G-Pereira/greenmobi-drive/hardware/docs/Untitled 1.ods

R | 4,7
C | 0,000001
t | 0,0000047
3t | 0,0000141
fsw | 3,00E+04
half period | 1,66666666666667E-05
leftover time to charge | 84,6
