G-Pereira/greenmobi-drive/hardware/greenmobi-drive.kicad_pcb

## KiCad design hardware/greenmobi-drive.kicad_pcb (2025-09-25)

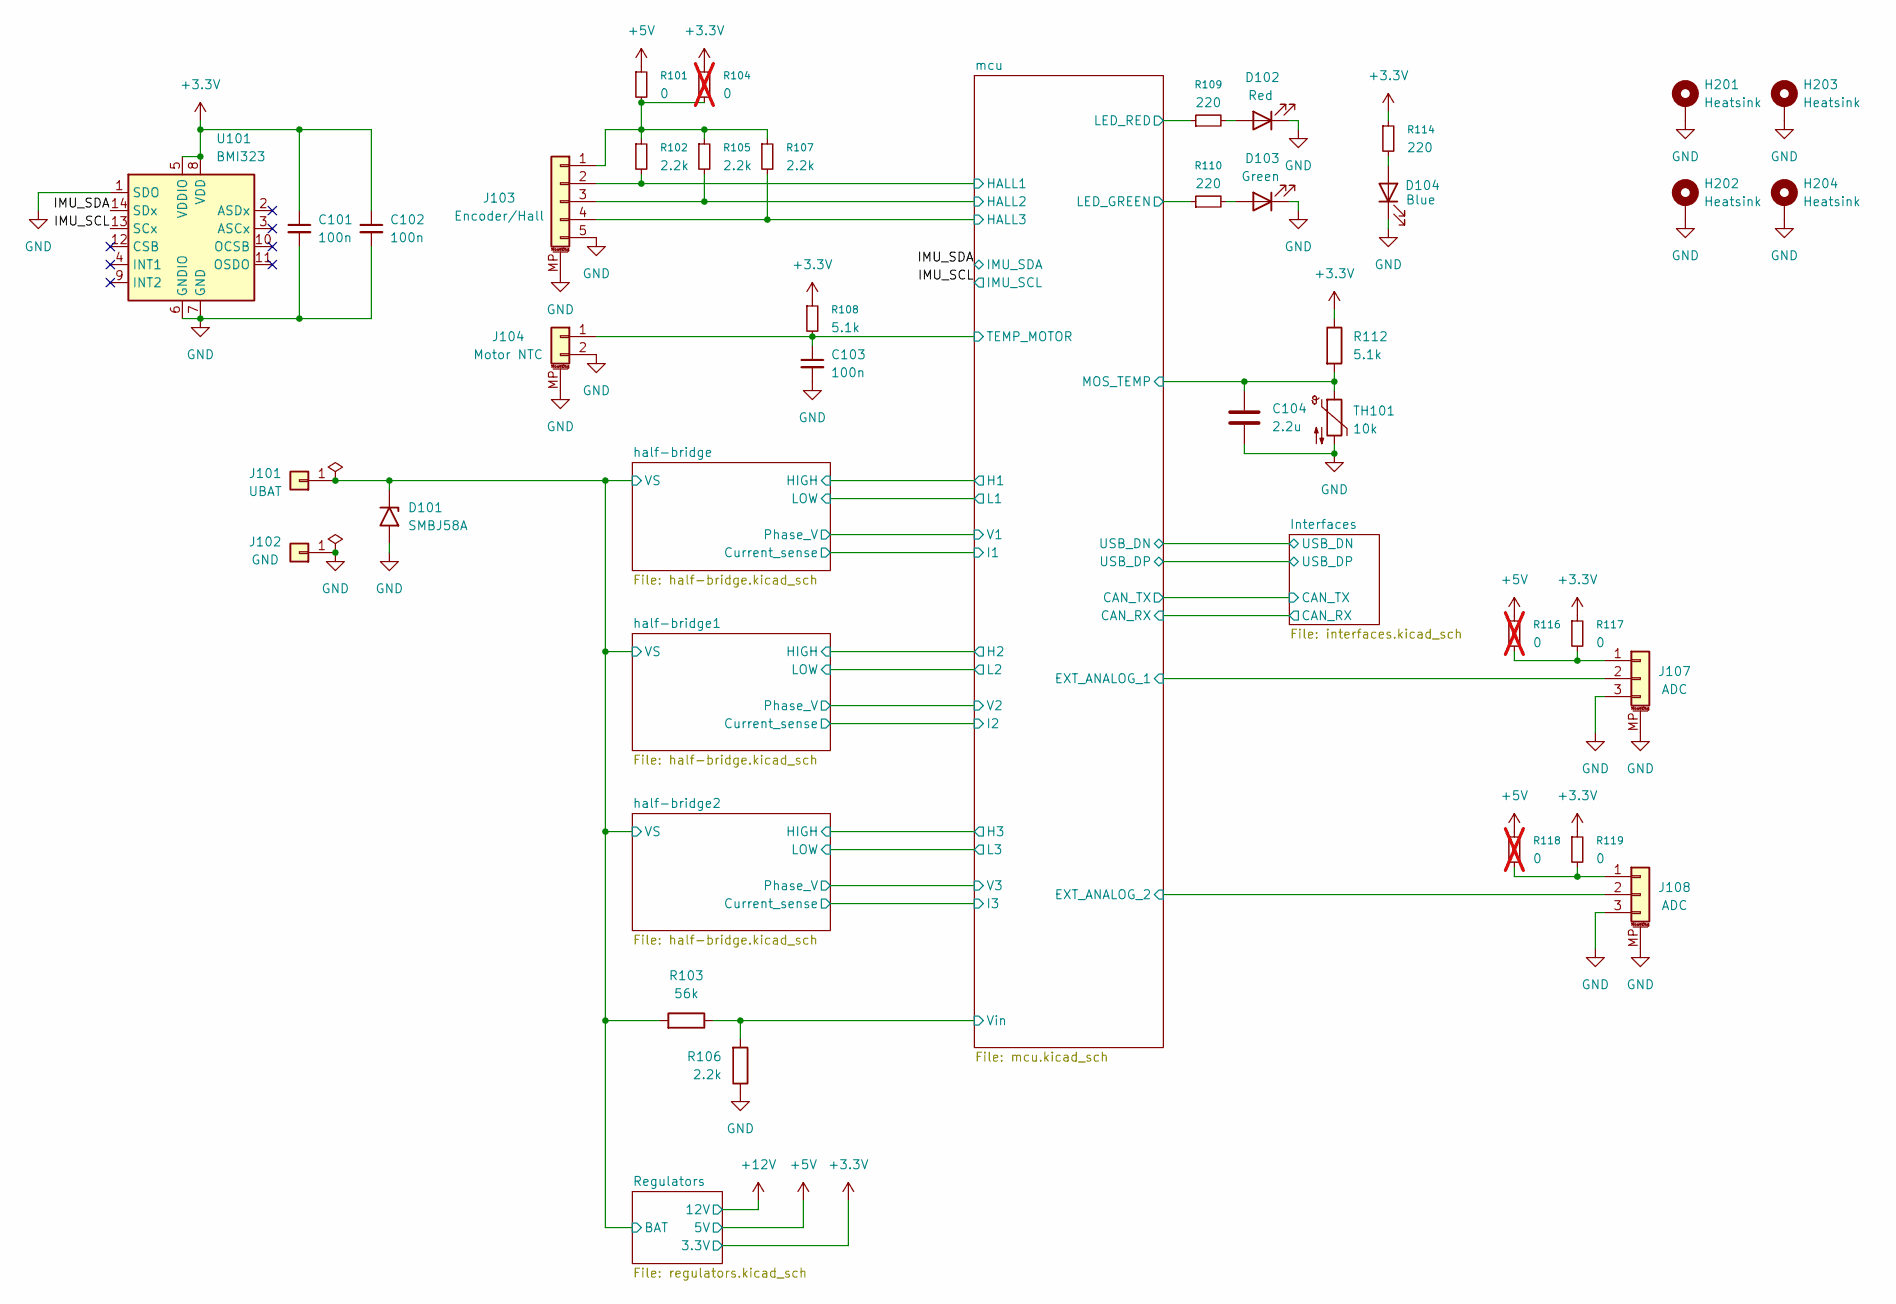
[picture p1: schematic greenmobi-drive.kicad_sch, GreenMobi Drive]

Parts:
C101, C102, C103: 100n; C_0402_1005Metric; LCSC C77020
C104: 2.2u; C_0402_1005Metric; LCSC C170151
D101: SMBJ58A; D_SMB; LCSC C151910
D102: Red; LED_0805_2012Metric; LCSC C688884
D103: Green; LED_0805_2012Metric; LCSC C688883
D104: Blue; LED_0805_2012Metric; LCSC C779459
H201, H202, H203, H204: Heatsink; MountingHole_3.2mm_M3_Pad
J101: UBAT; MountingHole_3.2mm_M3_ISO14580_Pad_TopBottom
J102: GND; MountingHole_3.2mm_M3_ISO14580_Pad_TopBottom
J103: Encoder/Hall; JST_PH_B5B-PH-SM4-TB_1x05-1MP_P2.00mm_Vertical; LCSC C17700383
J104: Motor NTC; JST_PH_B2B-PH-SM4-TB_1x02-1MP_P2.00mm_Vertical; LCSC C17700380
J107, J108: ADC; JST_PH_B3B-PH-SM4-TB_1x03-1MP_P2.00mm_Vertical; LCSC C17700383
R101, R117, R119: 0; R_0402_1005Metric; LCSC C106231
R102, R105, R106, R107: 2.2k; R_0402_1005Metric; LCSC C114762
R103: 56k; R_0805_2012Metric; LCSC C17756
R104, R116, R118: 0; R_0402_1005Metric; LCSC C106231; not fitted
R108, R112: 5.1k; R_0402_1005Metric; LCSC C25905
R109, R110, R114: 220; R_0402_1005Metric; LCSC C2909336
TH101: 10k; R_0402_1005Metric; LCSC C77131
U101: BMI323; Bosch_LGA-14_3x2.5mm_P0.5mm; LCSC C5368700

Connections:
+3.3V: C101.1, C102.1, R104.1, R108.1, R112.1, R114.1, R117.1, R119.1, U101.5 (VDDIO), U101.8 (VDD); also elsewhere on the board
+5V: R101.1, R116.1, R118.1; also elsewhere on the board
/IMU_SCL: U101.13 (SCx); also elsewhere on the board
/IMU_SDA: U101.14 (SDx); also elsewhere on the board
/Regulators/BAT: D101.1 (A1), J101.1, R103.2; also elsewhere on the board
/mcu/EXT_ANALOG_1: J107.2; also elsewhere on the board
/mcu/EXT_ANALOG_2: J108.2; also elsewhere on the board
/mcu/HALL1: J103.2, R102.2; also elsewhere on the board
/mcu/HALL2: J103.3, R105.2; also elsewhere on the board
/mcu/HALL3: J103.4, R107.2; also elsewhere on the board
/mcu/LED_GREEN: R110.1; also elsewhere on the board
/mcu/LED_RED: R109.1; also elsewhere on the board
/mcu/MOS_TEMP: C104.1, R112.2, TH101.1; also elsewhere on the board
/mcu/TEMP_MOTOR: C103.1, J104.1, R108.2; also elsewhere on the board
/mcu/Vin: R103.1, R106.2; also elsewhere on the board
GND: C101.2, C102.2, C103.2, C104.2, D101.2 (A2), D102.1 (K), D103.1 (K), D104.1 (K), H201.1, H202.1, H203.1, H204.1, J102.1, J103.5, J103.MP (MountPin), J104.2, J104.MP (MountPin), J107.3, J107.MP (MountPin), J108.3, J108.MP (MountPin), R106.1, TH101.2, U101.1 (SDO), U101.6 (GNDIO), U101.7 (GND); also elsewhere on the board
unnamed: D102.2 (A), R109.2
unnamed: D103.2 (A), R110.2
unnamed: D104.2 (A), R114.2
unnamed: J103.1, R101.2, R102.1, R104.2, R105.1, R107.1
unnamed: J107.1, R116.2, R117.2
unnamed: J108.1, R118.2, R119.2

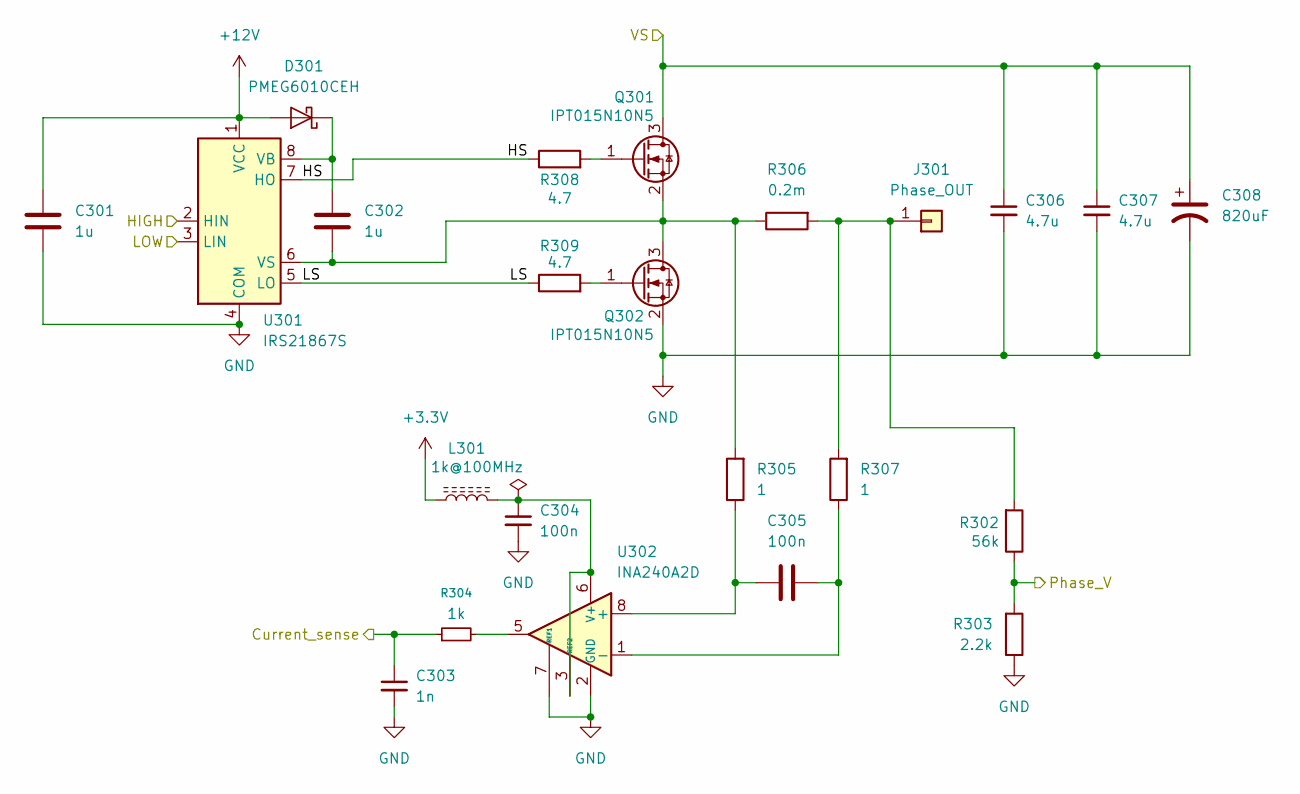
[picture p2: schematic half-bridge.kicad_sch, GreenMobi Drive]

Parts:
C301, C302: 1u; C_1206_3216Metric; LCSC C28322
C303: 1n; C_0402_1005Metric
C304, C305: 100n; C_0402_1005Metric; LCSC C77020
C306, C307: 4.7u; C_1210_3225Metric; LCSC C381466
C308: 820uF; CP_Radial_D18.0mm_P7.50mm; LCSC C700880
D301: PMEG6010CEH; D_SOD-123F; LCSC C110797
J301: Phase_OUT; SolderWirePad_1x01_SMD_4x8mm
L301: 1k@100MHz; L_0402_1005Metric; LCSC C76883
Q301, Q302: IPT015N10N5; Infineon_PG-HSOF-8-1_ThermalVias; LCSC C108964
R302: 56k; R_0805_2012Metric; LCSC C17756
R303: 2.2k; R_0402_1005Metric; LCSC C114762
R304: 1k; R_0402_1005Metric
R305, R307: 1; R_0402_1005Metric; LCSC C185446
R306: 0.2m; R_2512_6332Metric; LCSC C4944115
R308, R309: 4.7; R_0603_1608Metric; LCSC C25121
U301: IRS21867S; SOIC-8_3.9x4.9mm_P1.27mm; LCSC C52290
U302: INA240A2D; SOIC-8_3.9x4.9mm_P1.27mm; LCSC C2060768

Connections:
+3.3V: L301.1; also elsewhere on the board
+12V: C301.1, D301.2 (A), U301.1 (VCC); also elsewhere on the board
/Regulators/BAT: C306.1, C307.1, C308.1, Q301.3 (D); also elsewhere on the board
/half-bridge/Current_sense: C303.1, R304.1; also elsewhere on the board
/half-bridge/HIGH: U301.2 (HIN); also elsewhere on the board
/half-bridge/HS: R308.1, U301.7 (HO)
/half-bridge/LOW: U301.3 (LIN); also elsewhere on the board
/half-bridge/LS: R309.1, U301.5 (LO)
/half-bridge/Phase_V: R302.1, R303.2; also elsewhere on the board
GND: C301.2, C303.2, C304.2, C306.2, C307.2, C308.2, Q302.2 (S), R303.1, U301.4 (COM), U302.2 (GND), U302.4 (GND), U302.7 (REF1); also elsewhere on the board
unnamed: C302.1, D301.1 (K), U301.8 (VB)
unnamed: J301.1, R302.2, R306.2, R307.2
unnamed: Q301.1 (G), R308.2
unnamed: C302.2, Q301.2 (S), Q302.3 (D), R305.2, R306.1, U301.6 (VS)
unnamed: Q302.1 (G), R309.2
unnamed: R304.2, U302.5
unnamed: C305.2, R305.1, U302.8 (+)
unnamed: C305.1, R307.1, U302.1 (-)
unnamed: C304.1, L301.2, U302.3 (REF2), U302.6 (V+)

Parts of its further copies:
C401, C402, C501, C502: 1u; C_1206_3216Metric; LCSC C28322
C403, C503: 1n; C_0402_1005Metric
C404, C405, C504, C505: 100n; C_0402_1005Metric; LCSC C77020
C406, C407, C506, C507: 4.7u; C_1210_3225Metric; LCSC C381466
C408, C508: 820uF; CP_Radial_D18.0mm_P7.50mm; LCSC C700880
D401, D501: PMEG6010CEH; D_SOD-123F; LCSC C110797
J401, J501: Phase_OUT; SolderWirePad_1x01_SMD_4x8mm
L401, L501: 1k@100MHz; L_0402_1005Metric; LCSC C76883
Q401, Q402, Q501, Q502: IPT015N10N5; Infineon_PG-HSOF-8-1_ThermalVias; LCSC C108964
R402, R502: 56k; R_0805_2012Metric; LCSC C17756
R403, R503: 2.2k; R_0402_1005Metric; LCSC C114762
R404, R504: 1k; R_0402_1005Metric
R405, R407, R505, R507: 1; R_0402_1005Metric; LCSC C185446
R406, R506: 0.2m; R_2512_6332Metric; LCSC C4944115
R408, R409, R508, R509: 4.7; R_0603_1608Metric; LCSC C25121
U401, U501: IRS21867S; SOIC-8_3.9x4.9mm_P1.27mm; LCSC C52290
U402, U502: INA240A2D; SOIC-8_3.9x4.9mm_P1.27mm; LCSC C2060768

Connections of its further copies:
+3.3V: L401.1, L501.1; also elsewhere on the board
+12V: C401.1, C501.1, D401.2 (A), D501.2 (A), U401.1 (VCC), U501.1 (VCC); also elsewhere on the board
/Regulators/BAT: C406.1, C407.1, C408.1, C506.1, C507.1, C508.1, Q401.3 (D), Q501.3 (D); also elsewhere on the board
/half-bridge1/Current_sense: C403.1, R404.1; also elsewhere on the board
/half-bridge1/HIGH: U401.2 (HIN); also elsewhere on the board
/half-bridge1/HS: R408.1, U401.7 (HO)
/half-bridge1/LOW: U401.3 (LIN); also elsewhere on the board
/half-bridge1/LS: R409.1, U401.5 (LO)
/half-bridge1/Phase_V: R402.1, R403.2; also elsewhere on the board
/half-bridge2/Current_sense: C503.1, R504.1; also elsewhere on the board
/half-bridge2/HIGH: U501.2 (HIN); also elsewhere on the board
/half-bridge2/HS: R508.1, U501.7 (HO)
/half-bridge2/LOW: U501.3 (LIN); also elsewhere on the board
/half-bridge2/LS: R509.1, U501.5 (LO)
/half-bridge2/Phase_V: R502.1, R503.2; also elsewhere on the board
GND: C401.2, C403.2, C404.2, C406.2, C407.2, C408.2, C501.2, C503.2, C504.2, C506.2, C507.2, C508.2, Q402.2 (S), Q502.2 (S), R403.1, R503.1, U401.4 (COM), U402.2 (GND), U402.4 (GND), U402.7 (REF1), U501.4 (COM), U502.2 (GND), U502.4 (GND), U502.7 (REF1); also elsewhere on the board
unnamed: C402.1, D401.1 (K), U401.8 (VB)
unnamed: C502.1, D501.1 (K), U501.8 (VB)
unnamed: J401.1, R402.2, R406.2, R407.2
unnamed: J501.1, R502.2, R506.2, R507.2
unnamed: Q401.1 (G), R408.2
unnamed: C402.2, Q401.2 (S), Q402.3 (D), R405.2, R406.1, U401.6 (VS)
unnamed: Q402.1 (G), R409.2
unnamed: Q501.1 (G), R508.2
unnamed: C502.2, Q501.2 (S), Q502.3 (D), R505.2, R506.1, U501.6 (VS)
unnamed: Q502.1 (G), R509.2
unnamed: R404.2, U402.5
unnamed: R504.2, U502.5
unnamed: C405.2, R405.1, U402.8 (+)
unnamed: C405.1, R407.1, U402.1 (-)
unnamed: C404.1, L401.2, U402.3 (REF2), U402.6 (V+)
unnamed: C505.2, R505.1, U502.8 (+)
unnamed: C505.1, R507.1, U502.1 (-)
unnamed: C504.1, L501.2, U502.3 (REF2), U502.6 (V+)

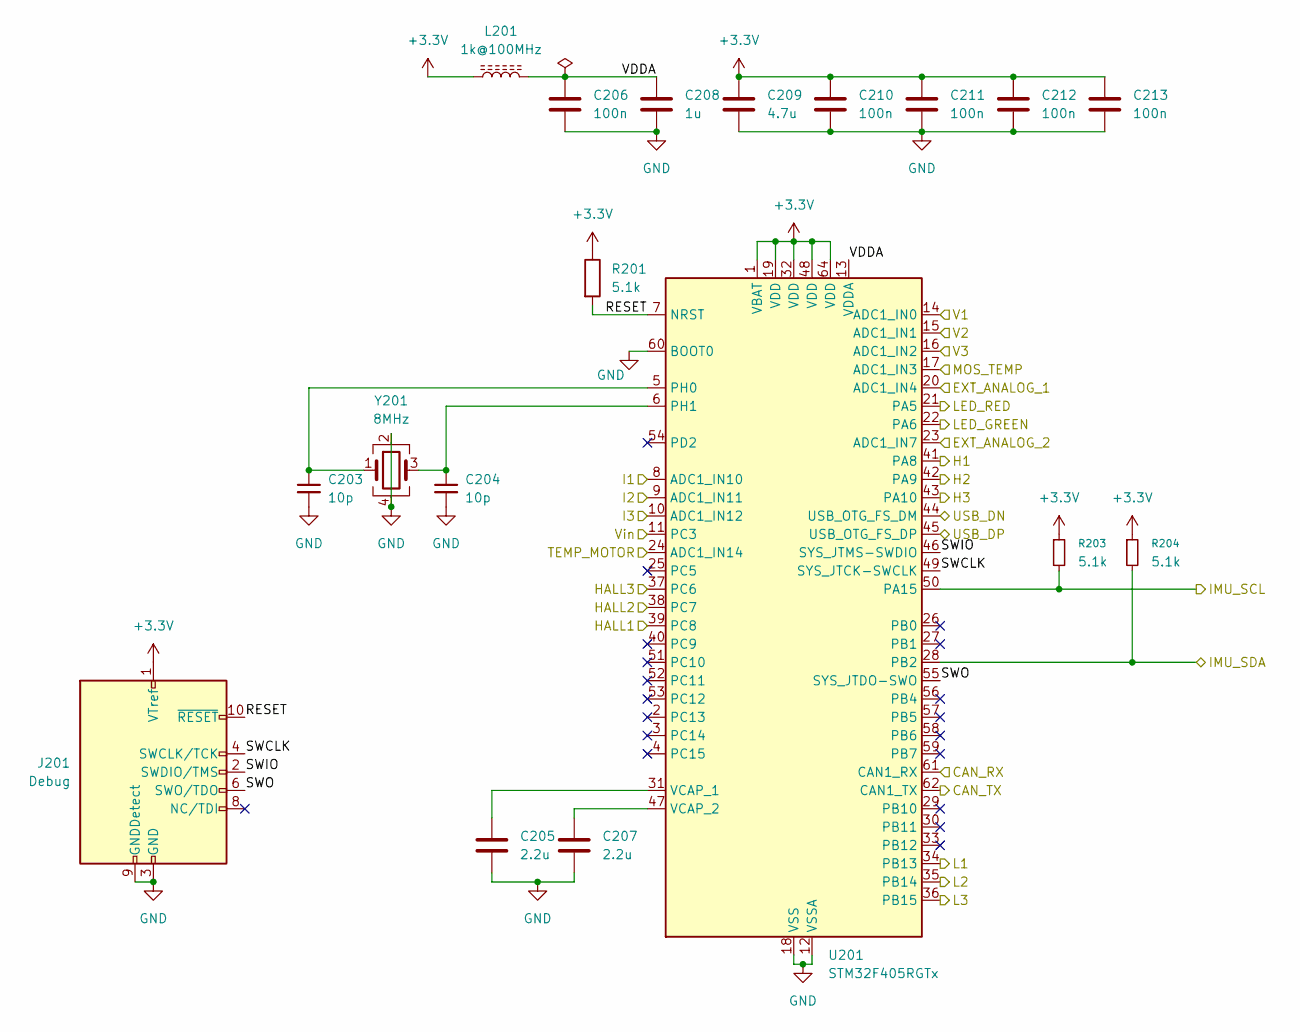
[picture p3: schematic mcu.kicad_sch, GreenMobi Drive]

Parts:
C203, C204: 10p; C_0402_1005Metric; LCSC C526994
C205, C207: 2.2u; C_0402_1005Metric; LCSC C170151
C206, C210, C211, C212, C213: 100n; C_0402_1005Metric; LCSC C77020
C208: 1u; C_0402_1005Metric; LCSC C14445
C209: 4.7u; C_0402_1005Metric; LCSC C23733
J201: Debug; PinHeader_2x05_P1.27mm_Vertical_SMD; LCSC C150517
L201: 1k@100MHz; L_0402_1005Metric; LCSC C76883
R201, R203, R204: 5.1k; R_0402_1005Metric; LCSC C25905
U201: STM32F405RGTx; LQFP-64_10x10mm_P0.5mm; LCSC C15742
Y201: 8MHz; Crystal_SMD_3225-4Pin_3.2x2.5mm; LCSC C400090

Connections:
+3.3V: C209.1, C210.1, C211.1, C212.1, C213.1, J201.1 (VTref), L201.1, R201.1, R203.1, R204.1, U201.1 (VBAT), U201.19 (VDD), U201.32 (VDD), U201.48 (VDD), U201.64 (VDD); also elsewhere on the board
/IMU_SCL: R203.2, U201.50 (PA15); also elsewhere on the board
/IMU_SDA: R204.2, U201.28 (PB2); also elsewhere on the board
/Interfaces/CAN_RX: U201.61 (CAN1_RX); also elsewhere on the board
/Interfaces/CAN_TX: U201.62 (CAN1_TX); also elsewhere on the board
/Interfaces/USB_DN: U201.44 (USB_OTG_FS_DM); also elsewhere on the board
/Interfaces/USB_DP: U201.45 (USB_OTG_FS_DP); also elsewhere on the board
/half-bridge1/Current_sense: U201.9 (ADC1_IN11); also elsewhere on the board
/half-bridge1/HIGH: U201.42 (PA9); also elsewhere on the board
/half-bridge1/LOW: U201.35 (PB14); also elsewhere on the board
/half-bridge1/Phase_V: U201.15 (ADC1_IN1); also elsewhere on the board
/half-bridge2/Current_sense: U201.10 (ADC1_IN12); also elsewhere on the board
/half-bridge2/HIGH: U201.43 (PA10); also elsewhere on the board
/half-bridge2/LOW: U201.36 (PB15); also elsewhere on the board
/half-bridge2/Phase_V: U201.16 (ADC1_IN2); also elsewhere on the board
/half-bridge/Current_sense: U201.8 (ADC1_IN10); also elsewhere on the board
/half-bridge/HIGH: U201.41 (PA8); also elsewhere on the board
/half-bridge/LOW: U201.34 (PB13); also elsewhere on the board
/half-bridge/Phase_V: U201.14 (ADC1_IN0); also elsewhere on the board
/mcu/EXT_ANALOG_1: U201.20 (ADC1_IN4); also elsewhere on the board
/mcu/EXT_ANALOG_2: U201.23 (ADC1_IN7); also elsewhere on the board
/mcu/HALL1: U201.39 (PC8); also elsewhere on the board
/mcu/HALL2: U201.38 (PC7); also elsewhere on the board
/mcu/HALL3: U201.37 (PC6); also elsewhere on the board
/mcu/LED_GREEN: U201.22 (PA6); also elsewhere on the board
/mcu/LED_RED: U201.21 (PA5); also elsewhere on the board
/mcu/MOS_TEMP: U201.17 (ADC1_IN3); also elsewhere on the board
/mcu/RESET: J201.10 (~RESET), R201.2, U201.7 (NRST)
/mcu/SWCLK: J201.4 (SWCLK/TCK), U201.49 (SYS_JTCK-SWCLK)
/mcu/SWIO: J201.2 (SWDIO/TMS), U201.46 (SYS_JTMS-SWDIO)
/mcu/SWO: J201.6 (SWO/TDO), U201.55 (SYS_JTDO-SWO)
/mcu/TEMP_MOTOR: U201.24 (ADC1_IN14); also elsewhere on the board
/mcu/VDDA: C206.1, C208.1, L201.2, U201.13 (VDDA)
/mcu/Vin: U201.11 (PC3); also elsewhere on the board
GND: C203.2, C204.2, C205.2, C206.2, C207.2, C208.2, C209.2, C210.2, C211.2, C212.2, C213.2, J201.3 (GND), J201.5 (GND), J201.9 (GNDDetect), U201.12 (VSSA), U201.18 (VSS), U201.60 (BOOT0), U201.63 (VSS), Y201.2, Y201.4; also elsewhere on the board
unnamed: C203.1, U201.5 (PH0), Y201.1
unnamed: C204.1, U201.6 (PH1), Y201.3
unnamed: C205.1, U201.31 (VCAP_1)
unnamed: C207.1, U201.47 (VCAP_2)

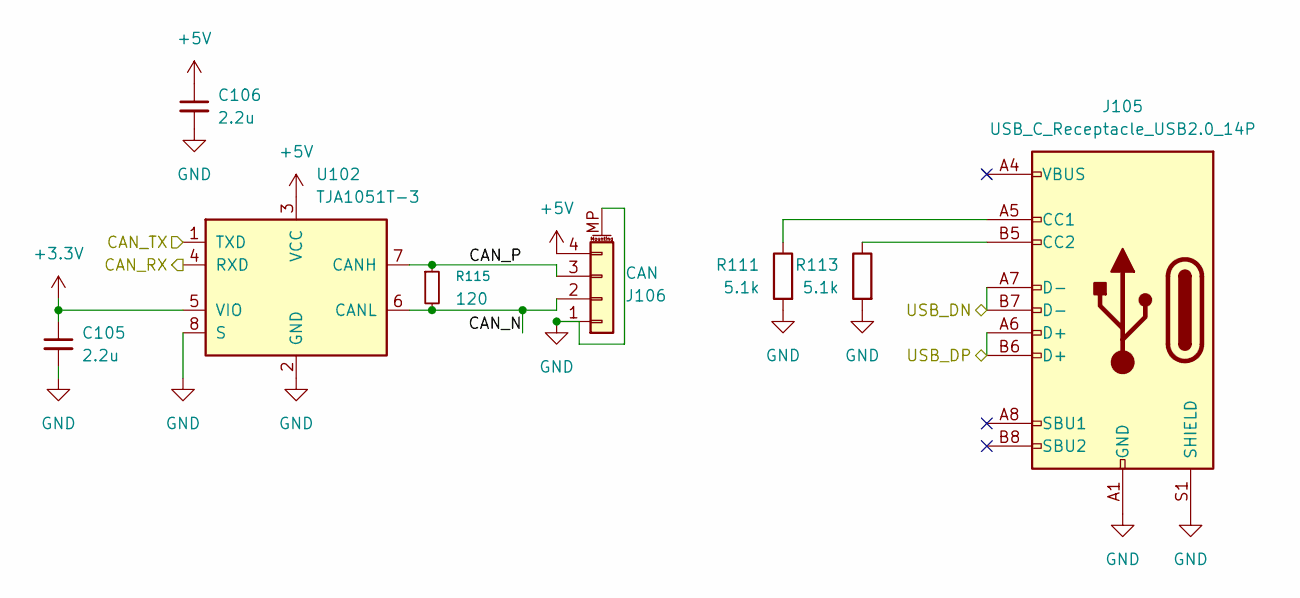
[picture p4: schematic interfaces.kicad_sch, GreenMobi Drive]

Parts:
C105, C106: 2.2u; C_0402_1005Metric; LCSC C170151
J105: USB_C_Receptacle_USB2.0_14P; USB_C_Receptacle_Palconn_UTC16-G; LCSC C2765186
J106: CAN; JST_PH_B4B-PH-SM4-TB_1x04-1MP_P2.00mm_Vertical; LCSC C17700382
R111, R113: 5.1k; R_0402_1005Metric; LCSC C25905
R115: 120; R_0402_1005Metric; LCSC C25079
U102: TJA1051T-3; SOIC-8_3.9x4.9mm_P1.27mm; LCSC C38695

Connections:
+3.3V: C105.1, U102.5 (VIO); also elsewhere on the board
+5V: C106.1, J106.4, U102.3 (VCC); also elsewhere on the board
/Interfaces/CAN_N: J106.2, R115.2, U102.6 (CANL)
/Interfaces/CAN_P: J106.3, R115.1, U102.7 (CANH)
/Interfaces/CAN_RX: U102.4 (RXD); also elsewhere on the board
/Interfaces/CAN_TX: U102.1 (TXD); also elsewhere on the board
/Interfaces/USB_DN: J105.A7 (D-), J105.B7 (D-); also elsewhere on the board
/Interfaces/USB_DP: J105.A6 (D+), J105.B6 (D+); also elsewhere on the board
GND: C105.2, C106.2, J105.A1 (GND), J105.A12 (GND), J105.B1 (GND), J105.B12 (GND), J105.S1 (SHIELD), J106.1, J106.MP (MountPin), R111.2, R113.2, U102.2 (GND), U102.8 (S); also elsewhere on the board
unnamed: J105.A5 (CC1), R111.1
unnamed: J105.B5 (CC2), R113.1

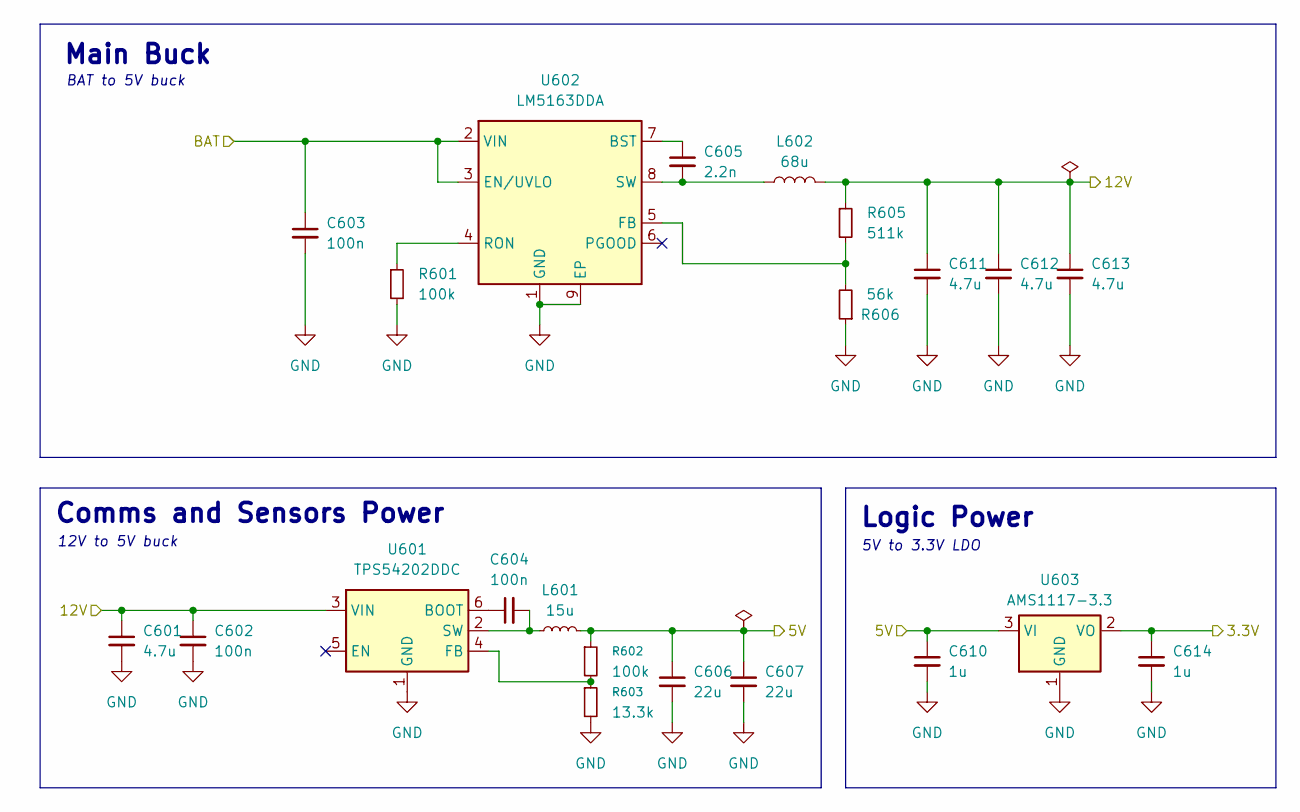
[picture p5: schematic regulators.kicad_sch, GreenMobi Drive]

Parts:
C601, C611, C612, C613: 4.7u; C_0805_2012Metric; LCSC C1779
C602, C604: 100n; C_0402_1005Metric; LCSC C77020
C603: 100n; C_1206_3216Metric; LCSC C110255
C605: 2.2n; C_0402_1005Metric; LCSC C106861
C606, C607: 22u; C_0805_2012Metric; LCSC C45783
C610, C614: 1u; C_1206_3216Metric; LCSC C28322
L601: 15u; L_Chilisin_BMRA00040420; LCSC C2894719
L602: 68u; L_KOHERelec_MDA7030; LCSC C2894721
R601, R602: 100k; R_0402_1005Metric; LCSC C60491
R603: 13.3k; R_0402_1005Metric; LCSC C2974007
R605: 511k; R_0603_1608Metric; LCSC C2930114
R606: 56k; R_0805_2012Metric; LCSC C17756
U601: TPS54202DDC; SOT-23-6; LCSC C191884
U602: LM5163DDA; HSOP-8-1EP_3.9x4.9mm_P1.27mm_EP2.41x3.1mm_ThermalVias; LCSC C2873264
U603: AMS1117-3.3; SOT-223-3_TabPin2; LCSC C6186

Connections:
+3.3V: C614.1, U603.2 (VO); also elsewhere on the board
+5V: C606.1, C607.1, C610.1, L601.2, R602.1, U603.3 (VI); also elsewhere on the board
+12V: C601.1, C602.1, C611.1, C612.1, C613.1, L602.2, R605.1, U601.3 (VIN); also elsewhere on the board
/Regulators/BAT: C603.1, U602.2 (VIN), U602.3 (EN/UVLO); also elsewhere on the board
GND: C601.2, C602.2, C603.2, C606.2, C607.2, C610.2, C611.2, C612.2, C613.2, C614.2, R601.2, R603.2, R606.1, U601.1 (GND), U602.1 (GND), U602.9 (EP), U603.1 (GND); also elsewhere on the board
unnamed: C604.1, U601.6 (BOOT)
unnamed: R602.2, R603.1, U601.4 (FB)
unnamed: C604.2, L601.1, U601.2 (SW)
unnamed: C605.1, U602.7 (BST)
unnamed: R605.2, R606.2, U602.5 (FB)
unnamed: R601.1, U602.4 (RON)
unnamed: C605.2, L602.1, U602.8 (SW)

Notes on the sheet:
Logic Power
5V to 3.3V LDO
BAT to 5V buck
Comms and Sensors Power
Main Buck
12V to 5V buck

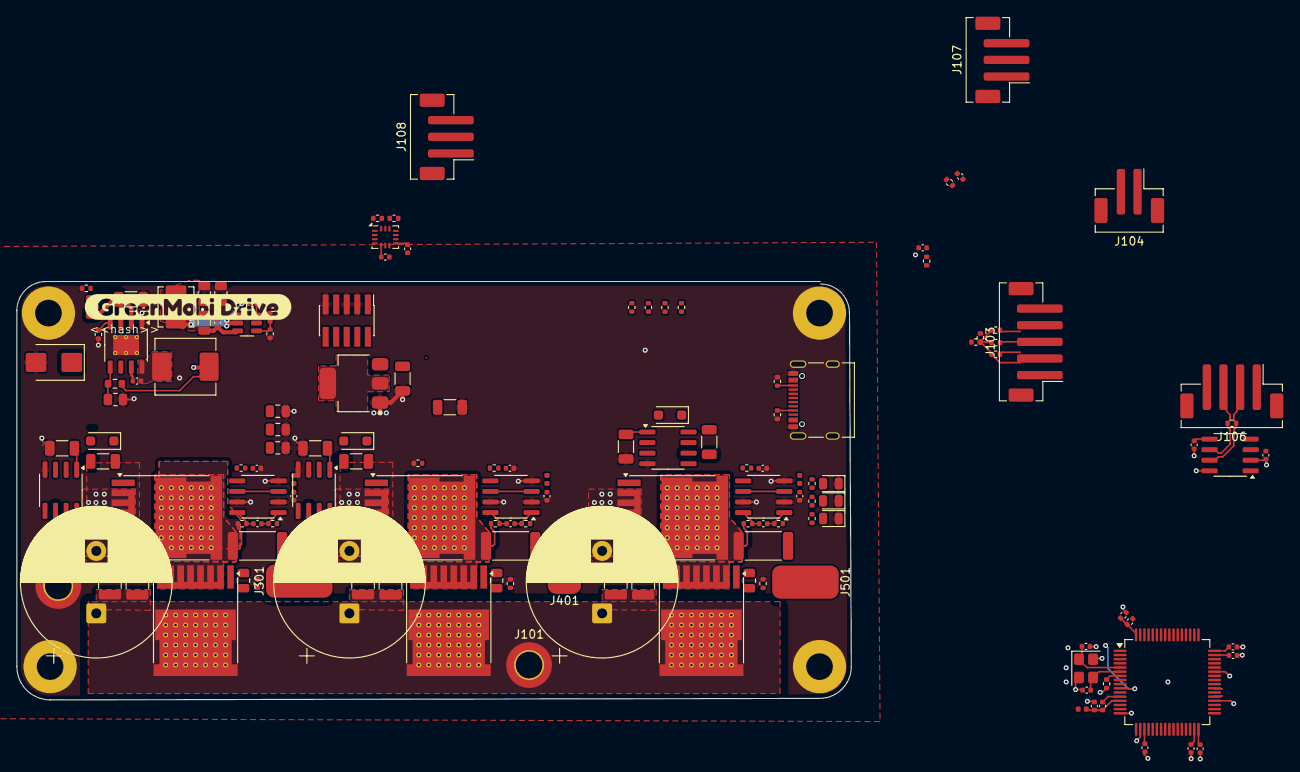
[picture p6: board greenmobi-drive.kicad_pcb from above]

Board: 2 copper layers, 100.3 x 50.3 mm, 154 parts (0 on the bottom side), 92 nets.

Other parts of the board:
kibuzzard-68C90E22: G***; kibuzzard-68C90E22
