G-Pereira/greenmobi-drive/software/hw_greenmobi_drive.c

#include "hw.h"

#include "ch.h"
#include "hal.h"
#include "stm32f4xx_conf.h"
#include "utils_math.h"
#include <math.h>
#include "mc_interface.h"

// Variables
static volatile bool i2c_running = false;

// I2C configuration
static const I2CConfig i2cfg = {
		OPMODE_I2C,
		100000,
		STD_DUTY_CYCLE
};

void hw_init_gpio(void) {
	// GPIO clock enable
	RCC_AHB1PeriphClockCmd(RCC_AHB1Periph_GPIOA, ENABLE);
	RCC_AHB1PeriphClockCmd(RCC_AHB1Periph_GPIOB, ENABLE);
	RCC_AHB1PeriphClockCmd(RCC_AHB1Periph_GPIOC, ENABLE);
	RCC_AHB1PeriphClockCmd(RCC_AHB1Periph_GPIOD, ENABLE);

	// LEDs
	palSetPadMode(LED_GREEN_GPIO, LED_GREEN_PIN,
			PAL_MODE_OUTPUT_PUSHPULL |
			PAL_STM32_OSPEED_HIGHEST);
	palSetPadMode(LED_RED_GPIO, LED_RED_PIN,
			PAL_MODE_OUTPUT_PUSHPULL |
			PAL_STM32_OSPEED_HIGHEST);

	// GPIOA Configuration: Channel 1 to 3 as alternate function push-pull
	palSetPadMode(GPIOA, 8, PAL_MODE_ALTERNATE(GPIO_AF_TIM1) |
			PAL_STM32_OSPEED_HIGHEST |
			PAL_STM32_PUDR_FLOATING);
	palSetPadMode(GPIOA, 9, PAL_MODE_ALTERNATE(GPIO_AF_TIM1) |
			PAL_STM32_OSPEED_HIGHEST |
			PAL_STM32_PUDR_FLOATING);
	palSetPadMode(GPIOA, 10, PAL_MODE_ALTERNATE(GPIO_AF_TIM1) |
			PAL_STM32_OSPEED_HIGHEST |
			PAL_STM32_PUDR_FLOATING);

	palSetPadMode(GPIOB, 13, PAL_MODE_ALTERNATE(GPIO_AF_TIM1) |
			PAL_STM32_OSPEED_HIGHEST |
			PAL_STM32_PUDR_FLOATING);
	palSetPadMode(GPIOB, 14, PAL_MODE_ALTERNATE(GPIO_AF_TIM1) |
			PAL_STM32_OSPEED_HIGHEST |
			PAL_STM32_PUDR_FLOATING);
	palSetPadMode(GPIOB, 15, PAL_MODE_ALTERNATE(GPIO_AF_TIM1) |
			PAL_STM32_OSPEED_HIGHEST |
			PAL_STM32_PUDR_FLOATING);

	// Hall sensors
	palSetPadMode(HW_HALL_ENC_GPIO1, HW_HALL_ENC_PIN1, PAL_MODE_INPUT_PULLUP);
	palSetPadMode(HW_HALL_ENC_GPIO2, HW_HALL_ENC_PIN2, PAL_MODE_INPUT_PULLUP);
	palSetPadMode(HW_HALL_ENC_GPIO3, HW_HALL_ENC_PIN3, PAL_MODE_INPUT_PULLUP);

	// ADC Pins
	palSetPadMode(GPIOA, 0, PAL_MODE_INPUT_ANALOG);
	palSetPadMode(GPIOA, 1, PAL_MODE_INPUT_ANALOG);
	palSetPadMode(GPIOA, 2, PAL_MODE_INPUT_ANALOG);
	palSetPadMode(GPIOA, 3, PAL_MODE_INPUT_ANALOG);

	palSetPadMode(GPIOC, 0, PAL_MODE_INPUT_ANALOG);
	palSetPadMode(GPIOC, 1, PAL_MODE_INPUT_ANALOG);
	palSetPadMode(GPIOC, 2, PAL_MODE_INPUT_ANALOG);
	palSetPadMode(GPIOC, 3, PAL_MODE_INPUT_ANALOG);
	palSetPadMode(GPIOC, 4, PAL_MODE_INPUT_ANALOG);
}

void hw_setup_adc_channels(void) {
	// ADC1 regular channels
	ADC_RegularChannelConfig(ADC1, ADC_Channel_10, 1, ADC_SampleTime_15Cycles);
	ADC_RegularChannelConfig(ADC1, ADC_Channel_0, 2, ADC_SampleTime_15Cycles);
	ADC_RegularChannelConfig(ADC1, ADC_Channel_14, 4, ADC_SampleTime_15Cycles);
	ADC_RegularChannelConfig(ADC1, ADC_Channel_Vrefint, 5, ADC_SampleTime_15Cycles);

	// ADC2 regular channels
	ADC_RegularChannelConfig(ADC2, ADC_Channel_11, 1, ADC_SampleTime_15Cycles);
	ADC_RegularChannelConfig(ADC2, ADC_Channel_1, 2, ADC_SampleTime_15Cycles);
	ADC_RegularChannelConfig(ADC2, ADC_Channel_0, 5, ADC_SampleTime_15Cycles);

	// ADC3 regular channels
	ADC_RegularChannelConfig(ADC3, ADC_Channel_12, 1, ADC_SampleTime_15Cycles);
	ADC_RegularChannelConfig(ADC3, ADC_Channel_2, 2, ADC_SampleTime_15Cycles);
	ADC_RegularChannelConfig(ADC3, ADC_Channel_3, 3, ADC_SampleTime_15Cycles);
	ADC_RegularChannelConfig(ADC3, ADC_Channel_13, 4, ADC_SampleTime_15Cycles);
	ADC_RegularChannelConfig(ADC3, ADC_Channel_1, 5, ADC_SampleTime_15Cycles);
	ADC_RegularChannelConfig(ADC3, ADC_Channel_2, 6, ADC_SampleTime_15Cycles);

	// Injected channels
	ADC_InjectedChannelConfig(ADC1, ADC_Channel_10, 1, ADC_SampleTime_15Cycles);
	ADC_InjectedChannelConfig(ADC2, ADC_Channel_11, 1, ADC_SampleTime_15Cycles);
	ADC_InjectedChannelConfig(ADC3, ADC_Channel_12, 1, ADC_SampleTime_15Cycles);
	ADC_InjectedChannelConfig(ADC1, ADC_Channel_10, 2, ADC_SampleTime_15Cycles);
	ADC_InjectedChannelConfig(ADC2, ADC_Channel_11, 2, ADC_SampleTime_15Cycles);
	ADC_InjectedChannelConfig(ADC3, ADC_Channel_12, 2, ADC_SampleTime_15Cycles);
	ADC_InjectedChannelConfig(ADC1, ADC_Channel_10, 3, ADC_SampleTime_15Cycles);
	ADC_InjectedChannelConfig(ADC2, ADC_Channel_11, 3, ADC_SampleTime_15Cycles);
	ADC_InjectedChannelConfig(ADC3, ADC_Channel_12, 3, ADC_SampleTime_15Cycles);
}

void hw_start_i2c(void) {}
void hw_stop_i2c(void) {}
void hw_try_restore_i2c(void) {}
