G-Pereira/greenmobi-drive/(commit log)

2025-03-09 MCU schematic
    [mcu.kicad_sch, motor-drive.kicad_pcb, motor-drive.kicad_sch]
2025-03-09 Define footprints
    [mcu.kicad_sch, motor-drive.kicad_pcb, motor-drive.kicad_sch]
2025-03-09 MCU layout
    [mcu.kicad_sch, motor-drive.kicad_pcb, motor-drive.kicad_sch]
2025-03-09 Added power connector
    [mcu.kicad_sch, motor-drive.kicad_pcb, motor-drive.kicad_sch]
2025-03-09 Started work on half bridges
    [half-bridge.kicad_sch, motor-drive.kicad_pcb, motor-drive.kicad_sch]
2025-06-04 Add CAN, USB and sensors
    [mcu.kicad_sch, motor-drive.kicad_sch]
2025-06-04 Add a board edge to test CI
    [greenmobi-drive.kicad_pcb]
2025-06-08 half bridges
    [greenmobi-drive.kicad_pcb, greenmobi-drive.kicad_sch, half-bridge.kicad_sch, mcu.kicad_sch, regulators.kicad_sch]
2025-06-08 phase capacitors
    [greenmobi-drive.kicad_pcb, greenmobi-drive.kicad_sch, half-bridge.kicad_sch, mcu.kicad_sch, regulators.kicad_sch]
2025-07-01 Placement study
    [greenmobi-drive.kicad_pcb, greenmobi-drive.kicad_sch, half-bridge.kicad_sch]
2025-07-05 Power Layout
    [greenmobi-drive.kicad_pcb, greenmobi-drive.kicad_sch, half-bridge.kicad_sch, mcu.kicad_sch, regulators.kicad_sch]
2025-07-08 Added IMU
    [greenmobi-drive.kicad_pcb, greenmobi-drive.kicad_sch, regulators.kicad_sch]
2025-07-08 5V regulator
    [regulators.kicad_sch]
2025-07-22 Regulators layout
    [greenmobi-drive.kicad_pcb, half-bridge.kicad_sch, regulators.kicad_sch]
2025-07-24 Placement complete
    [greenmobi-drive.kicad_pcb, half-bridge.kicad_sch]
2025-07-30 Layout mostly done
    [greenmobi-drive.kicad_pcb, greenmobi-drive.kicad_sch, mcu.kicad_sch]
2025-07-31 BOM optimizations
    [greenmobi-drive.kicad_pcb, greenmobi-drive.kicad_sch, half-bridge.kicad_sch, mcu.kicad_sch, regulators.kicad_sch]
2025-08-02 Mounting holes alignment
    [greenmobi-drive.kicad_pcb, greenmobi-drive.kicad_sch, mcu.kicad_sch]
2025-08-02 Remove soldermask under heat critical components
    [greenmobi-drive.kicad_pcb]
2025-08-02 Round corners
    [greenmobi-drive.kicad_pcb]
2025-08-02 Move traces away from USB
    [greenmobi-drive.kicad_pcb]
2025-08-02 Capacitors sourced
    [greenmobi-drive.kicad_sch, half-bridge.kicad_sch, mcu.kicad_sch, regulators.kicad_sch]
2025-08-02 Sourcing complete
    [greenmobi-drive.kicad_sch, half-bridge.kicad_sch, mcu.kicad_sch, regulators.kicad_sch]
2025-08-28 Fix LCSC part number on regulator output caps
    [regulators.kicad_sch]
2025-08-28 Add missing I2C pullups
    [greenmobi-drive.kicad_pcb, greenmobi-drive.kicad_sch, mcu.kicad_sch]
2025-08-31 Change power connections to pads instead of holes
    [greenmobi-drive.kicad_pcb, greenmobi-drive.kicad_sch, half-bridge.kicad_sch]
2025-08-31 Allow CI to attach files to releases
2025-08-31 Make DRC happy
    [greenmobi-drive.kicad_sch, mcu.kicad_sch]
2025-08-31 Revert "Allow CI to attach files to releases"
    This reverts commit b270502710a3843402cecd3094dd57504ff374fd.
2025-09-03 Reduce gate MOSFET current
    [half-bridge.kicad_sch]
2025-09-08 TVS and eletrolythic cap
    [Untitled 1.ods, greenmobi-drive.kicad_pcb, greenmobi-drive.kicad_sch, half-bridge.kicad_sch, mcu.kicad_sch, regulators.kicad_sch]
2025-09-08 Change solder wire pads
    [greenmobi-drive.kicad_pcb, greenmobi-drive.kicad_sch, half-bridge.kicad_sch]
2025-09-09 Added external analog inputs
    [greenmobi-drive.kicad_pcb, greenmobi-drive.kicad_sch, half-bridge.kicad_sch, interfaces.kicad_sch, mcu.kicad_sch, regulators.kicad_sch]
2025-09-09 Removed buttons for boot and reset
    [greenmobi-drive.kicad_pcb, greenmobi-drive.kicad_sch, mcu.kicad_sch]
2025-09-11 ERC exclusions
    [mcu.kicad_sch]
2025-09-15 Changed bootstrap resistor to 0 Ohm
    [greenmobi-drive.kicad_pcb, greenmobi-drive.kicad_sch, half-bridge.kicad_sch]
2025-09-15 Reduce board size
    [greenmobi-drive.kicad_pcb, greenmobi-drive.kicad_sch, half-bridge.kicad_sch, mcu.kicad_sch, regulators.kicad_sch]
2025-09-15 Test fit on 50x100mm
    [greenmobi-drive.kicad_pcb]
2025-09-22 Changed bootstrap diode and gate resistor
    [greenmobi-drive.kicad_pcb, greenmobi-drive.kicad_sch, half-bridge.kicad_sch]
2025-09-25 Layout work
    [greenmobi-drive.kicad_pcb, greenmobi-drive.kicad_sch, interfaces.kicad_sch]
